YogeshPMagi/Level-shifter-Design_Analysis/Images/Screenshot 2026-02-22 193523.png

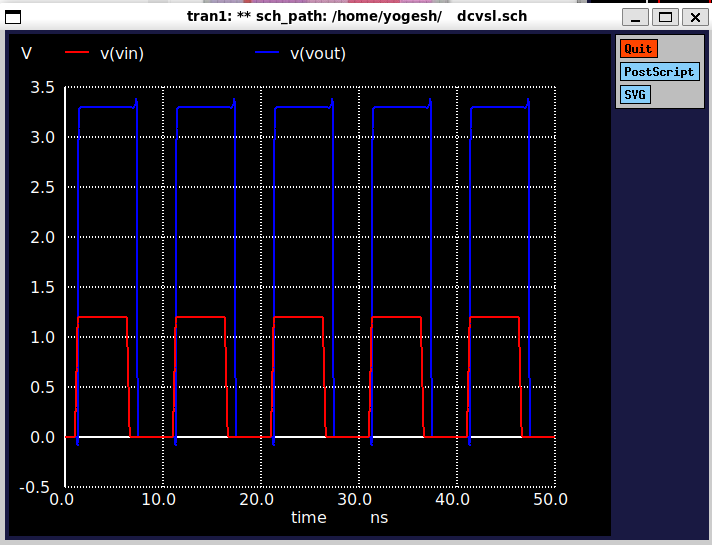
Images/Screenshot 2026-02-22 193523.png
