YogeshPMagi/Level-shifter-Design_Analysis/post_lay data.png

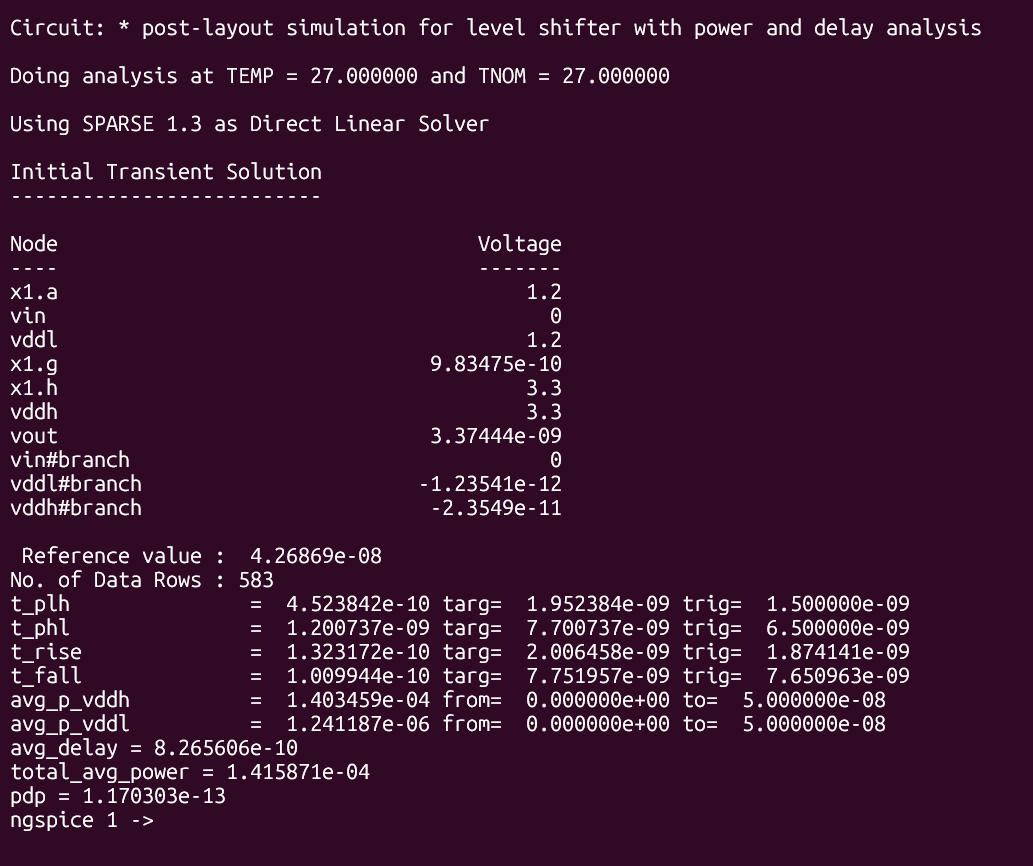
post_lay data.png
