YogeshPMagi/Level-shifter-Design_Analysis/PRE_POst layout comp.png

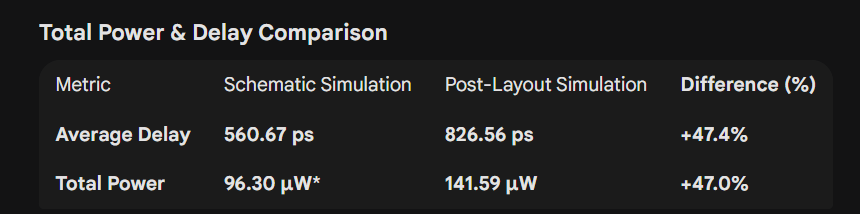
PRE_POst layout comp.png
